Jeff-Birt/C64_C128_Amiga_Mitsumi_Key_Tester/Complete_Fixture.PNG

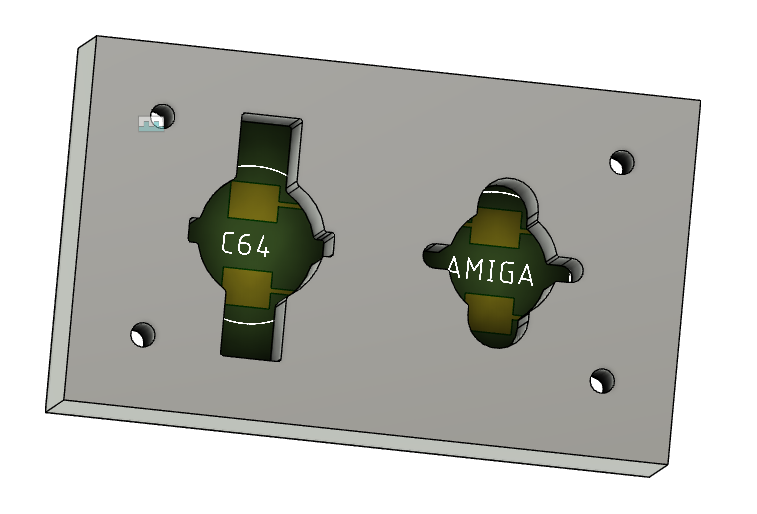
Complete_Fixture.PNG
