Jeff-Birt/C64_C128_Amiga_Mitsumi_Key_Tester/PCB.PNG

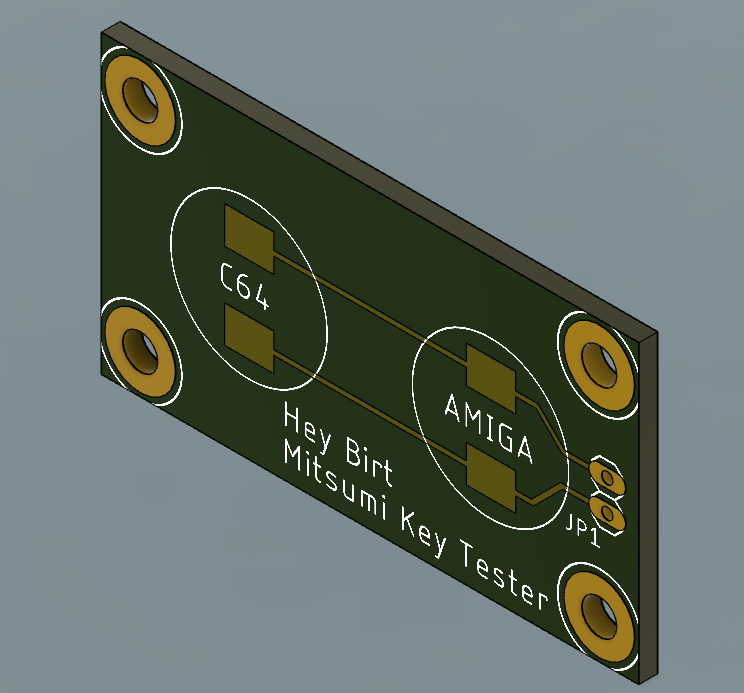
PCB.PNG
