Jeff-Birt/C64_C128_Amiga_Mitsumi_Key_Tester/Fixture 3D Print Files/C64 C128 Amiga Mitsumi Fixture v25.stl

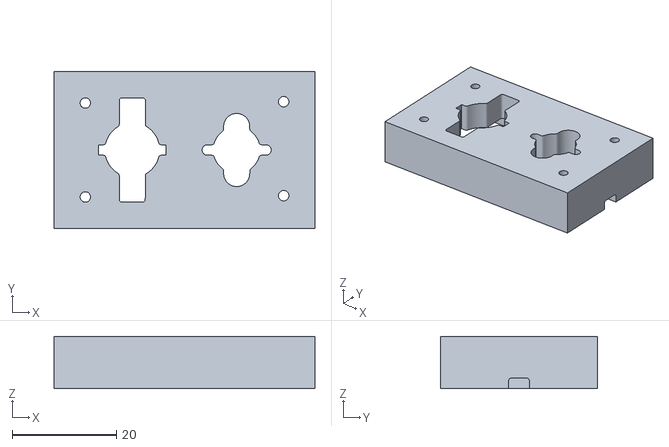
[picture p3: CAD file, 2020-08-19]
Fixture 3D Print Files/C64 C128 Amiga Mitsumi Fixture v25.stl
50.0 x 30.0 x 10.0
