Jeff-Birt/C64_C128_Amiga_Mitsumi_Key_Tester/Fixture 3D Print Files/C64 C128 Amiga Mitsumi Fixture v21.stl

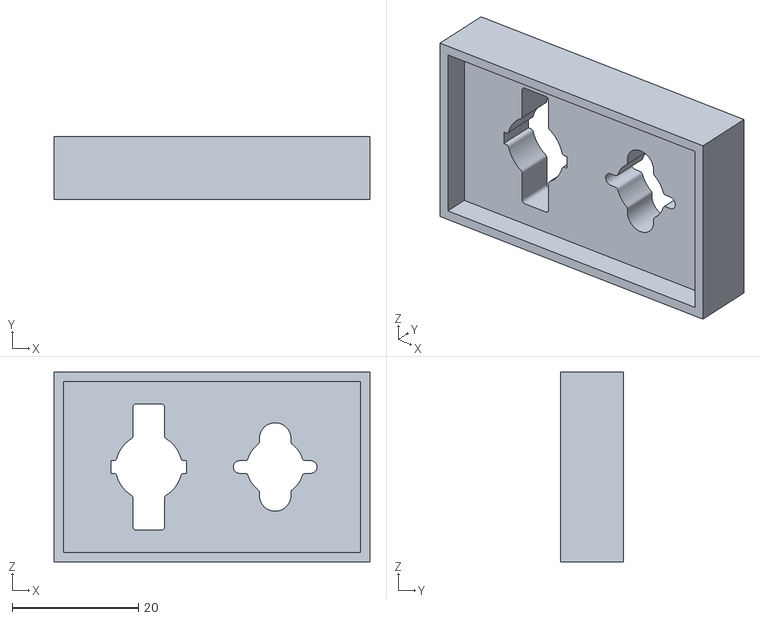
[picture p4: CAD file, 2020-08-02, an earlier design]
Fixture 3D Print Files/C64 C128 Amiga Mitsumi Fixture v21.stl
50.0 x 10.0 x 30.0
