Jeff-Birt/C64_C128_Amiga_Mitsumi_Key_Tester/(list of files, cad)

Other CAD files:
Fusion 360 Complete Design/C64 C128 Amiga Mitsumi Fixture v22.f3z
Fusion 360 Complete Design/C64 C128 Amiga Mitsumi Fixture v25.f3z
Fusion 360 Complete Design/Mitsumi PCB v24.f3z
