Jeff-Birt/C64_C128_Amiga_Mitsumi_Key_Tester/Mitsumi_Key_Plunger_Kit_Instructions.pdf

# Soigeneris MitKey_KIT

Hey Birt! Amiga, C64,

# C128 key stem tester

### User’s Manual V1.0

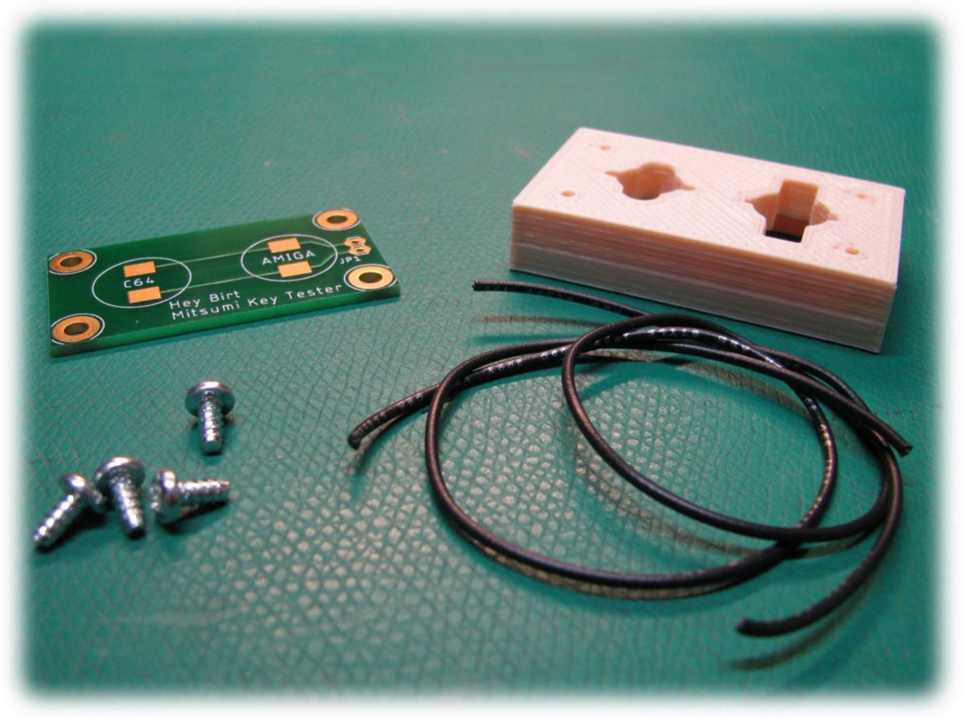
[picture p5: figure]

Page 2

304 Fox Creek Road
Rolla, MO 65401 US
573-647-9294

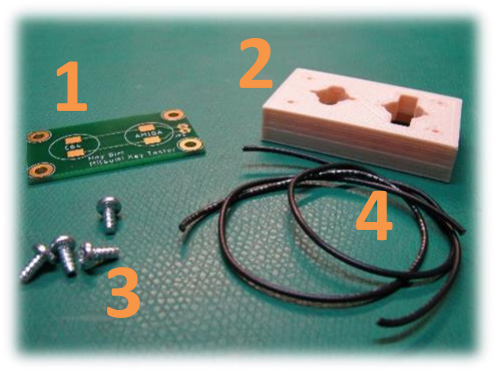
[picture p6: figure]

What’s Included in Kit

1) PCB, ENIG (gold) finish
2) 3D Printed housing
3) Screws, #4 or 3mm
4) #24AWG wire, 8” length, 2 pieces

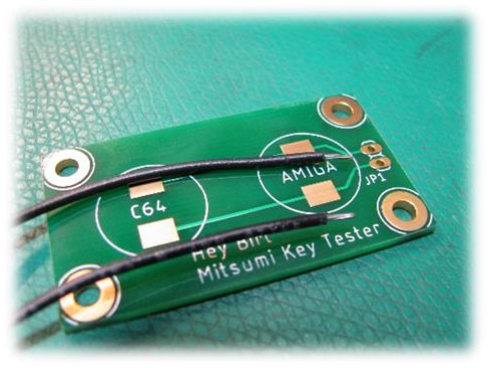
[picture p7: figure]

Directions

1) Strip about 3mm (1/8”) from ends of wires.

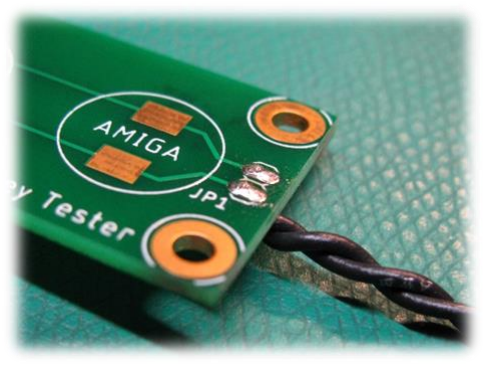
[picture p8: figure]

2) Insert wires from bottom of PCB, solder and trim

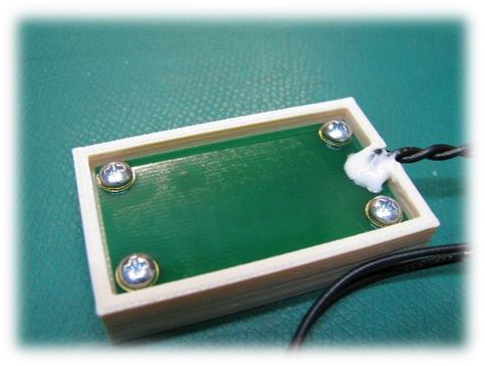
[picture p9: figure]

3) Place PCB into housing,
secure with 4 screws. A small dot of silicone or E6000 glue makes for a good strain relief.

Page 3

Rolla, MO 65401 US
573-647-9294

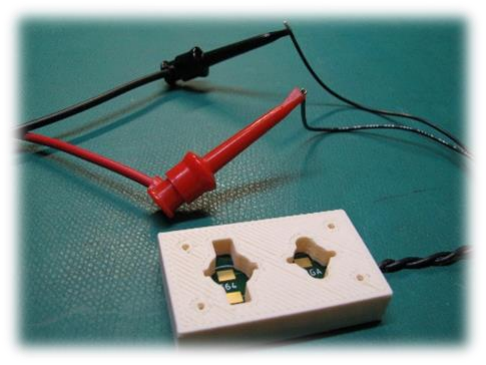
[picture p10: figure]

Usage

1) Connect ohmmeter to key tester leads.

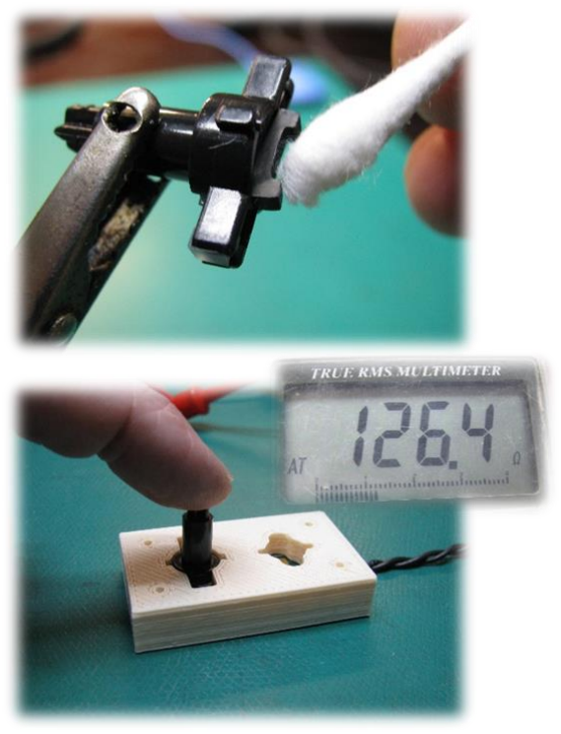
[picture p11: figure]

2) Clean rubber key contact with alcohol.
3) Insert key stem into matching aperture press lightly and take resistance reading.

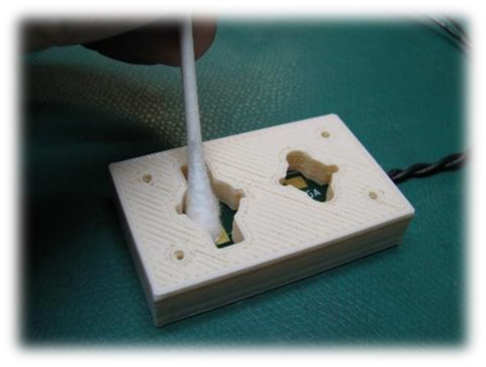
[picture p12: figure]

TIP: If gold contacts on PCB become dirty, clean very lightly with an alcohol-soaked cotton swab.

Page 4

Rolla, MO 65401 US
573-647-9294

Notes

Experience has shown that for Amiga, C128 and C64 keys that about 200ohms resistance of the key contact rubber is normal. The maximum resistance that seems to be OK is about 1KOhm.

The rubber can be cleaned to rejuvenate its conductive properties. A complete how to video can be found at: https://youtu.be/n9gGz2n-sBU

This is an open source project created by Jeffrey T. Birt, a.k.a. ‘Hey Birt!’ Project files can be downloaded from the link below.

Github repository: https://github.com/Jeff-Birt/C64_C128_Amiga_Mitsumi_Key_Tester
