Jeff-Birt/C64_C128_Amiga_Mitsumi_Key_Tester/(commit log)

2020-06-15 Initial commit
    Firs set up project files uploaded
    [C64 C128 Amiga Mitsumi Fixture v17.f3z, C64 C128 Amiga Mitsumi Fixture v18.stl]
2020-06-28 Updated Fusion360 model to parameterize PCB opening and key step openings
    [C64 C128 Amiga Mitsumi Fixture v17.f3z, C64 C128 Amiga Mitsumi Fixture v21.f3z]
2020-08-02 Updated design files
    [C64 C128 Amiga Mitsumi Fixture v18.stl, C64 C128 Amiga Mitsumi Fixture v21.f3z, C64 C128 Amiga Mitsumi Fixture v21.stl, C64 C128 Amiga Mitsumi Fixture v22.f3z, Mitsumi PCB v24.f3z]
2020-08-19 Updated housing to fit tighter to the new JLCPCB board which just arrived.
    [C64 C128 Amiga Mitsumi Fixture v25.f3z, C64 C128 Amiga Mitsumi Fixture v25.stl]
